ryood/AS3340/CEM+3340+Schematic.png

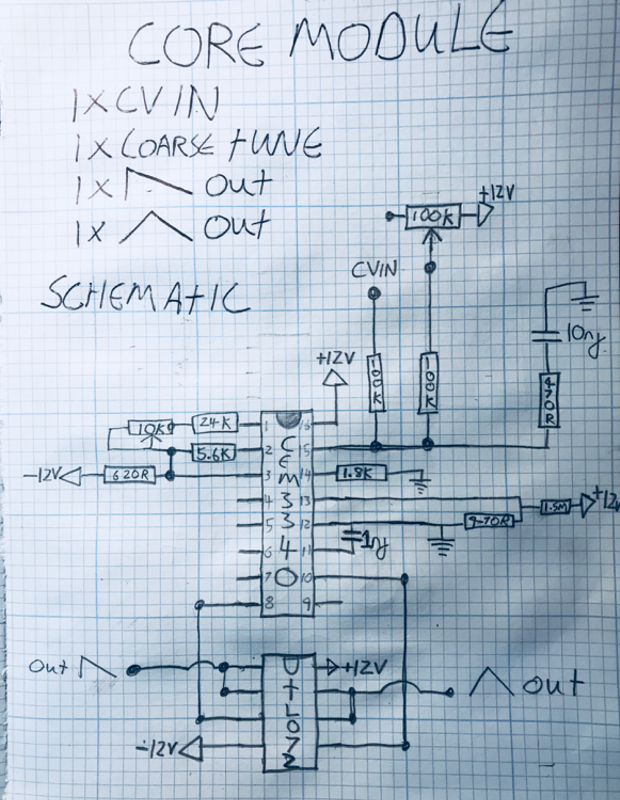
CEM+3340+Schematic.png
