ryood/AS3340/PXL_20220223_082210303.MP.jpg

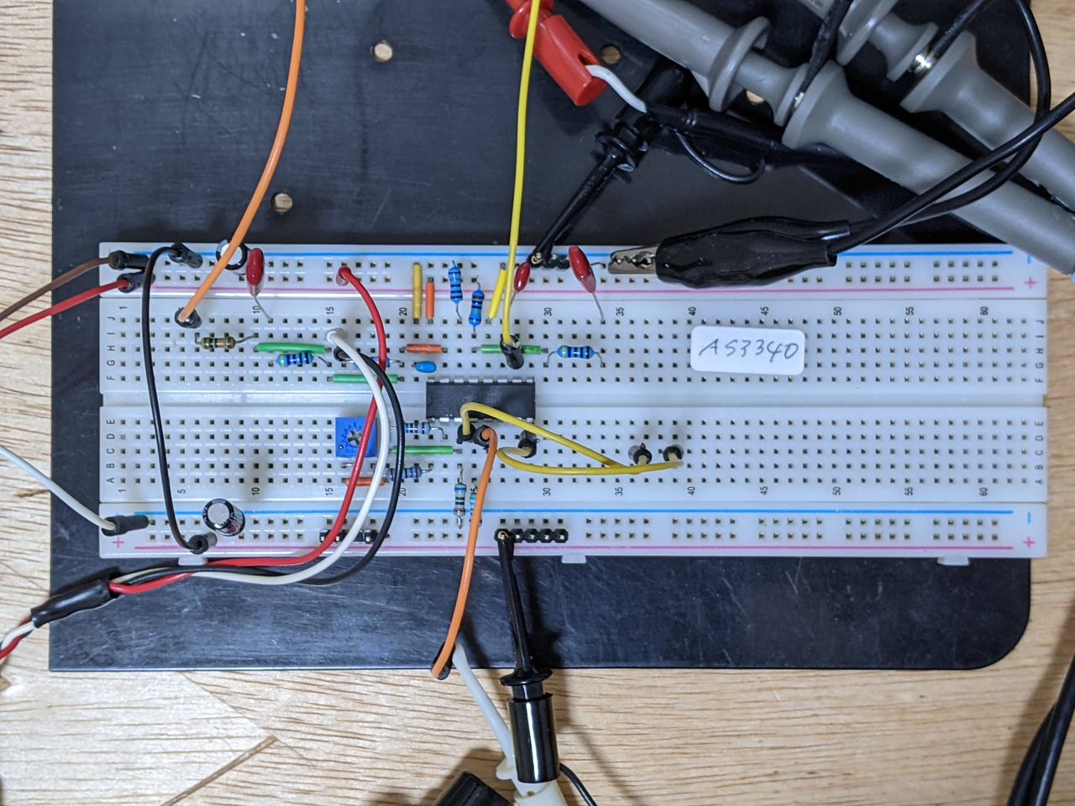
PXL_20220223_082210303.MP.jpg
