ryood/AS3340/AS3340_Error.png

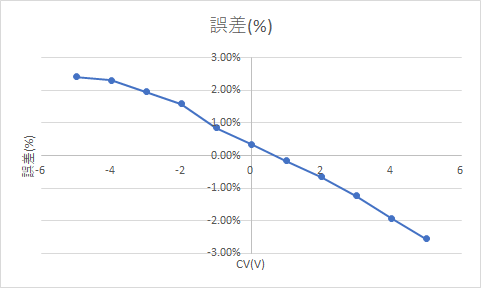
AS3340_Error.png
