ryood/AS3340/オシロ/Pulse_PWM=2V.png

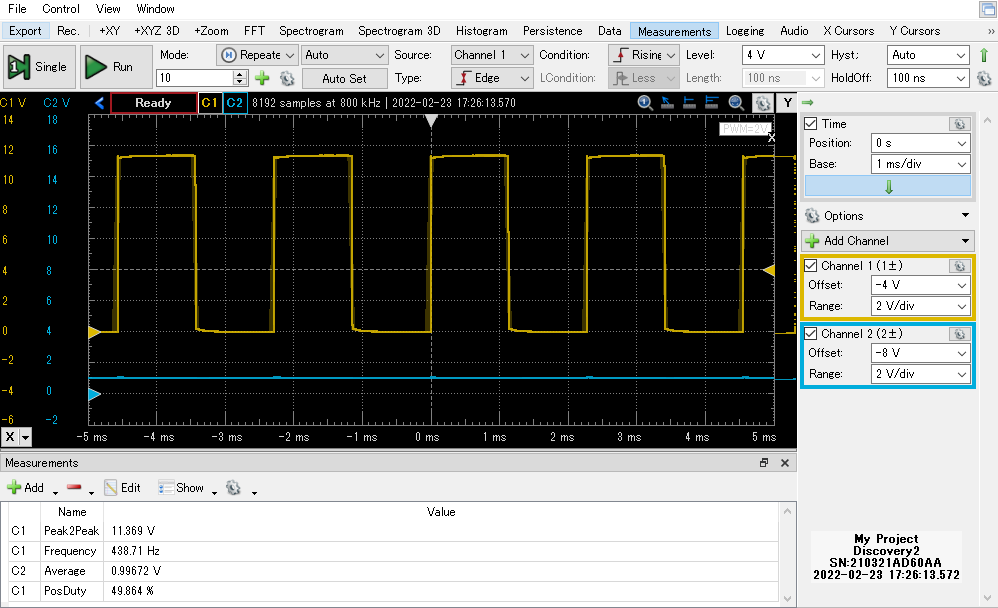
オシロ/Pulse_PWM=2V.png
