ryood/AS3340/オシロ/Saw_CV=0V.png

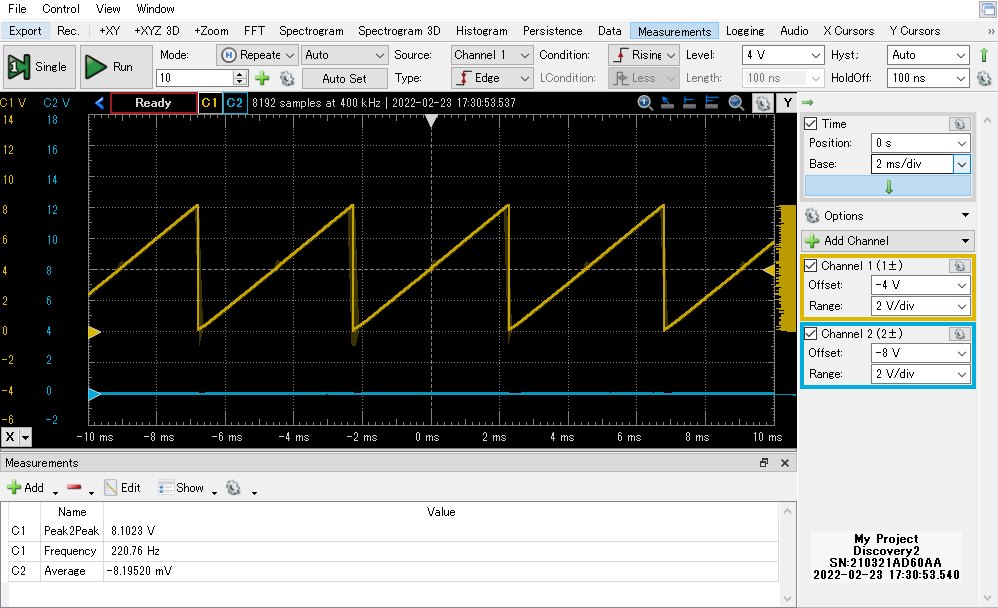
オシロ/Saw_CV=0V.png
