ryood/AS3340/オシロ/Saw_CV=+2V.png

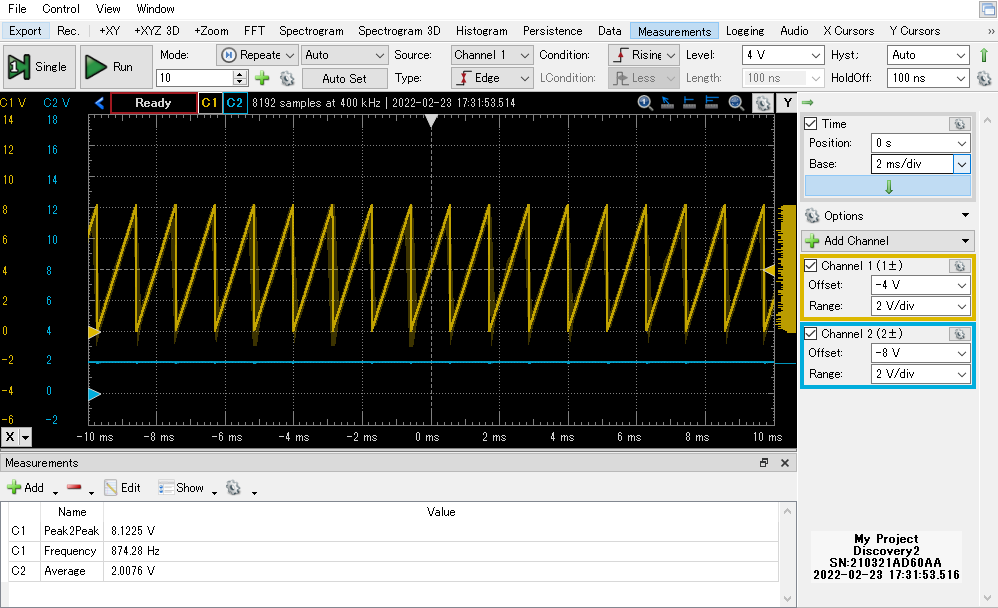
オシロ/Saw_CV=+2V.png
