ryood/AS3340/オシロ/Saw_CV=+4V.png

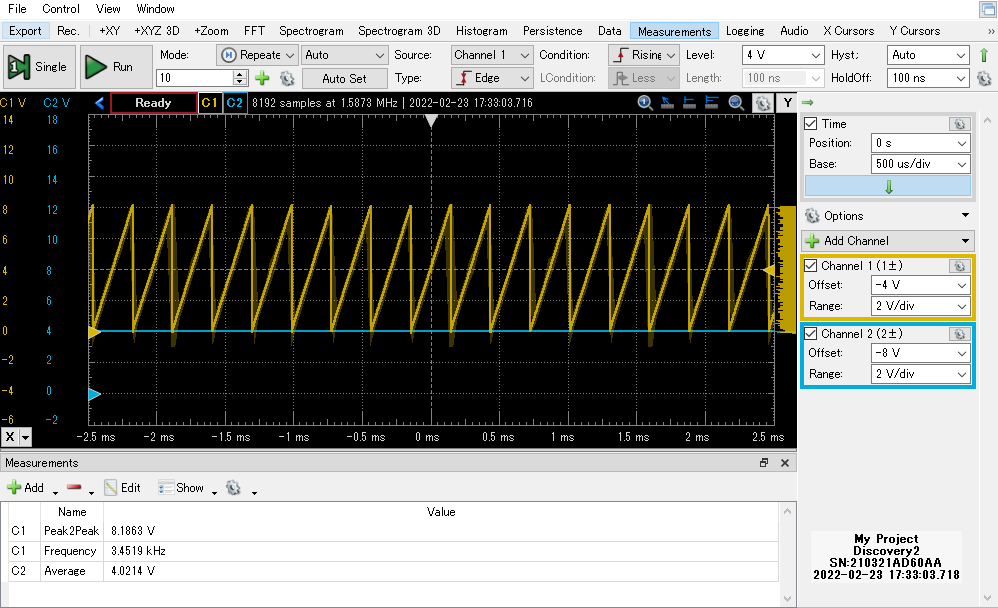
オシロ/Saw_CV=+4V.png
