ryood/AS3340/オシロ/Saw_CV=+5V.png

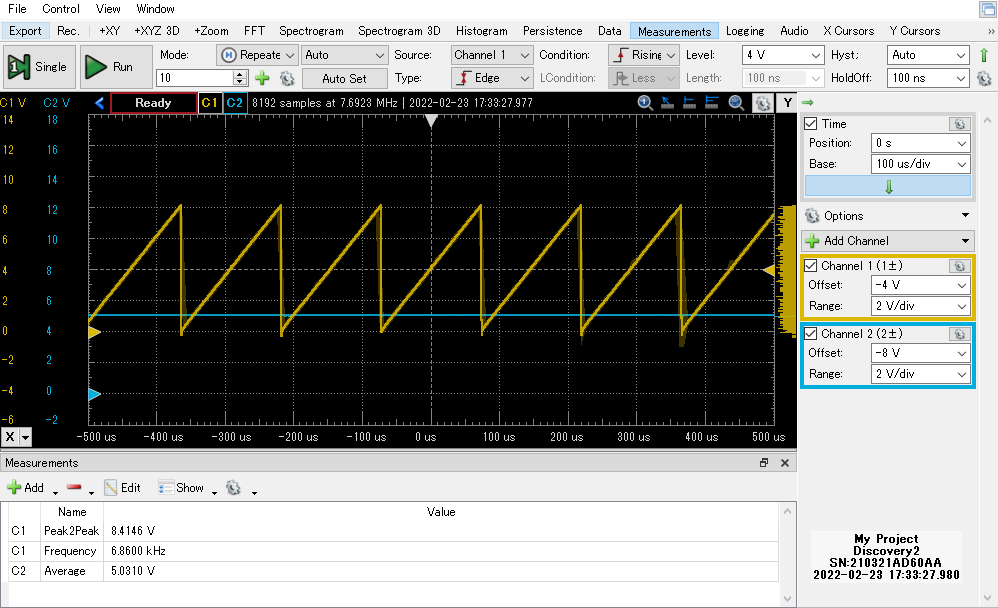
オシロ/Saw_CV=+5V.png
