ryood/AS3340/オシロ/Saw_CV=-1V.png

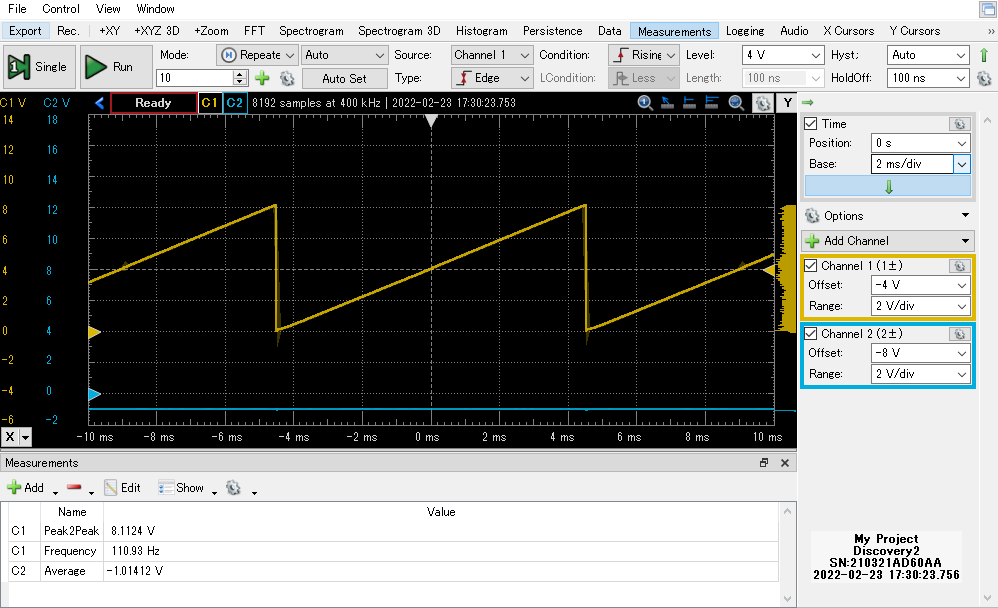
オシロ/Saw_CV=-1V.png
