ryood/AS3340/オシロ/Triangle.png

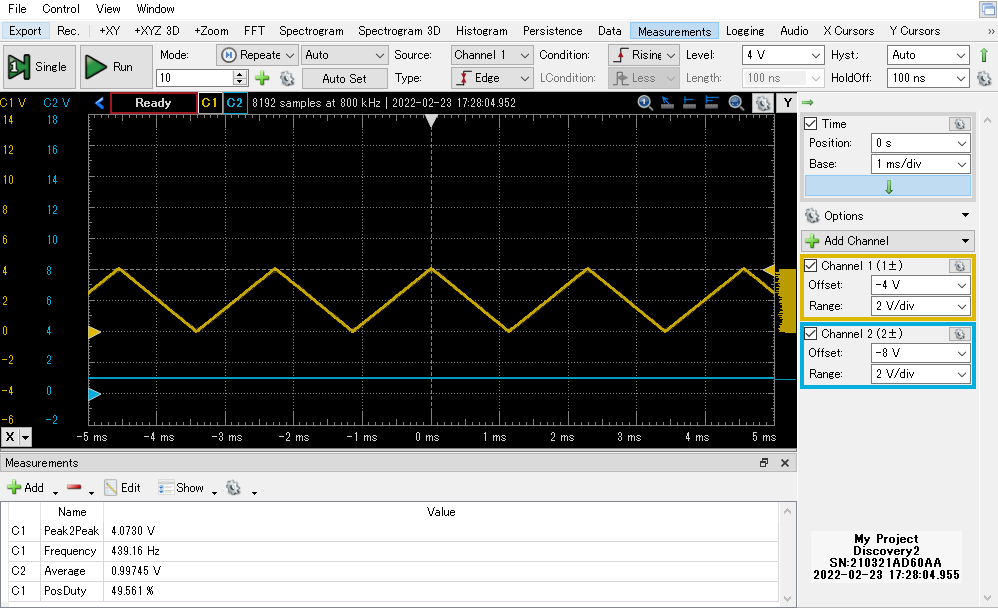
オシロ/Triangle.png
