ryood/AS3340/(list of files, drawings)

Other design files:
frittzing/AS3340_Test.fzz
