ryood/AS3340/KiCAD/AS3340_Test/AS3340_Test.sch

## KiCad design KiCAD/AS3340_Test/AS3340_Test.sch (2022-02-24)

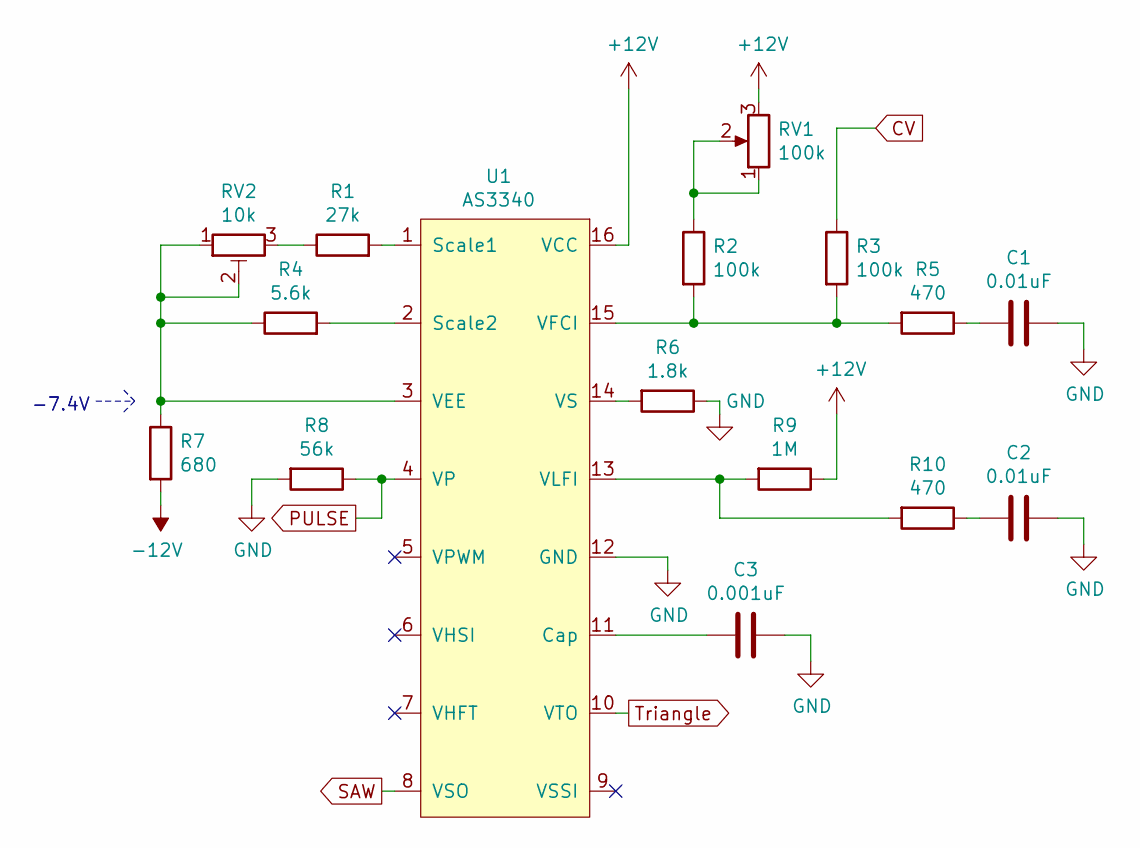
[picture p14: schematic AS3340_Test.sch]

Parts:
C1, C2: 0.01uF
C3: 0.001uF
R1: 27k
R2, R3: 100k
R4: 5.6k
R5, R10: 470
R6: 1.8k
R7: 680
R8: 56k
R9: 1M
RV1: 100k
RV2: 10k
U1: AS3340; DIP-16_W7.62mm_Socket

Connections:
+12V: R9.1, RV1.3, U1.16 (VCC)
-12V: R7.2
CV: R3.1
GND: C1.1, C2.1, C3.1, R6.1, R8.2, U1.12 (GND)
unnamed: C1.2, R5.1
unnamed: C2.2, R10.1
unnamed: C3.2, U1.11 (Cap)
unnamed: R1.1, RV2.3
unnamed: R1.2, U1.1 (Scale1)
unnamed: R2.1, RV1.1, RV1.2
unnamed: R2.2, R3.2, R5.2, U1.15 (VFCI)
unnamed: R4.1, R7.1, RV2.1, RV2.2, U1.3 (VEE)
unnamed: R4.2, U1.2 (Scale2)
unnamed: R6.2, U1.14 (VS)
unnamed: R9.2, R10.2, U1.13 (VLFI)
PULSE: R8.1, U1.4 (VP)
SAW: U1.8 (VSO)
Triangle: U1.10 (VTO)

Notes on the sheet:
-7.4V
