ryood/AS3340/AS3340_Test.xlsx

CV(V) | 期待周波数(Hz) | 実測周波数(Hz) | 誤差(Hz) | 誤差(%)
-5 | 6.875 | 7.0411 | 0.1661 | 2.42%
-4 | 13.75 | 14.068 | 0.318 | 2.31%
-3 | 27.5 | 28.04 | 0.54 | 1.96%
-2 | 55 | 55.879 | 0.879 | 1.60%
-1 | 110 | 110.93 | 0.93 | 0.85%
0 | 220 | 220.76 | 0.76 | 0.35%
1 | 440 | 439.3 | -0.7 | -0.16%
2 | 880 | 874.28 | -5.72 | -0.65%
3 | 1760 | 1738.3 | -21.7 | -1.23%
4 | 3520 | 3451.9 | -68.1 | -1.93%
5 | 7040 | 6860 | -180 | -2.56%
