ryood/AS3340/frittzing/AS3340_Test_ブレッドボード.png

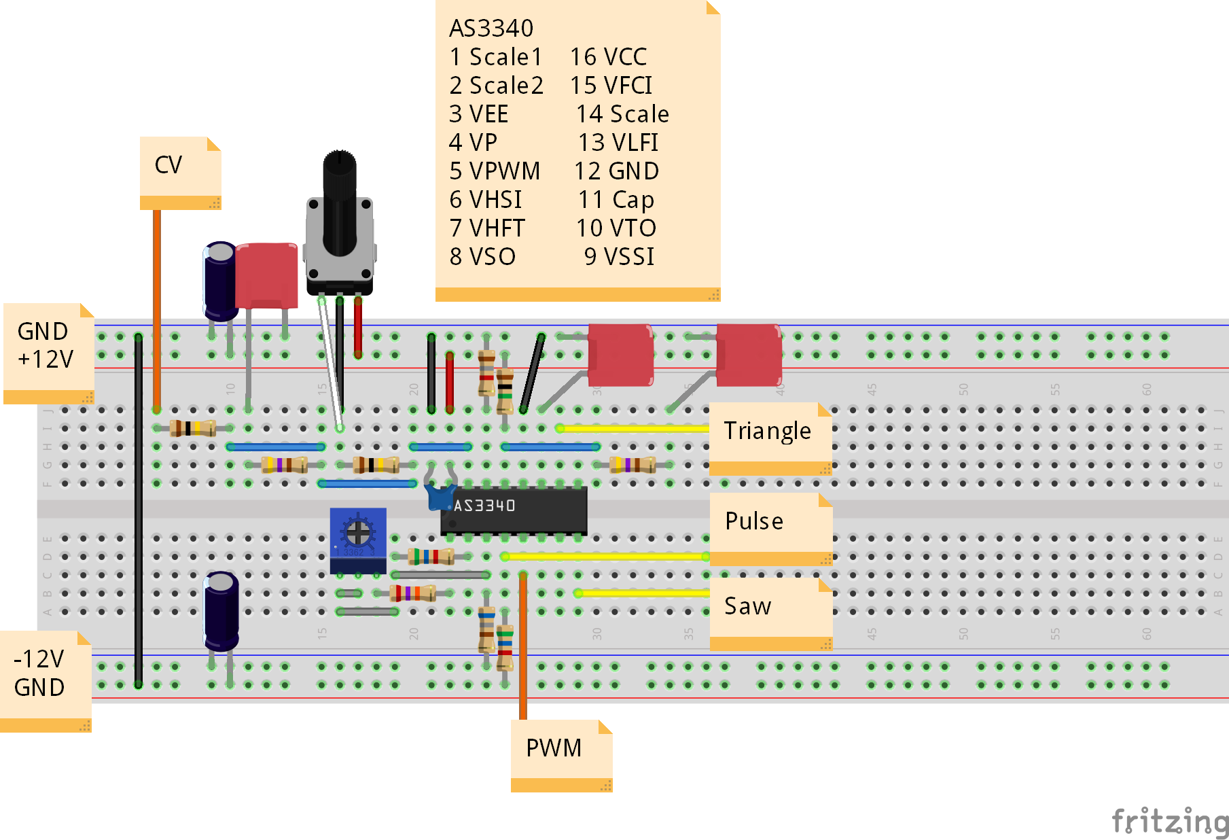
frittzing/AS3340_Test_ブレッドボード.png
