ryood/AS3340/KiCAD/AS3340_Test_sch.jpg

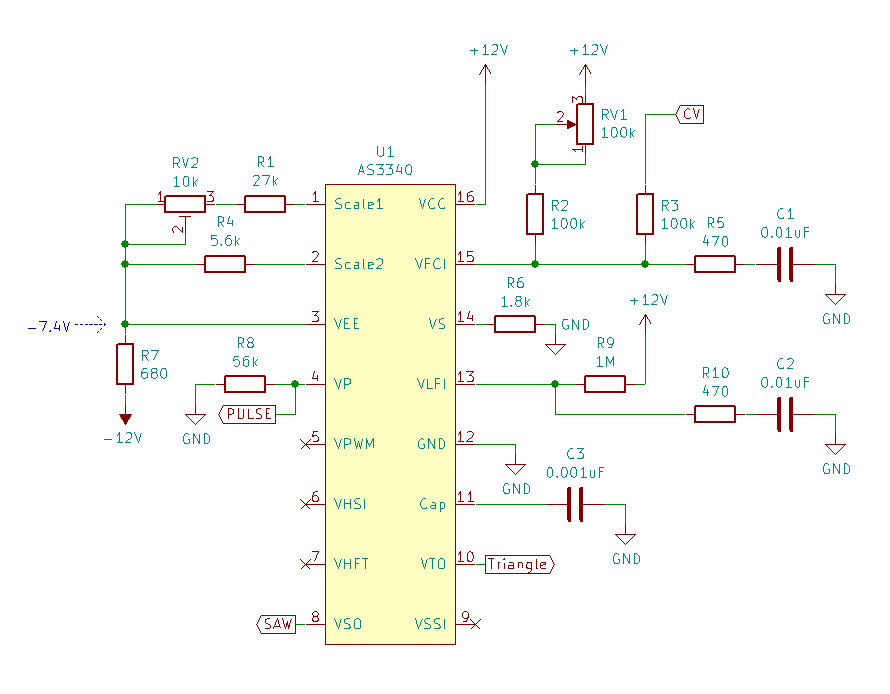
KiCAD/AS3340_Test_sch.jpg
